DawidMachulak/MacroApp/print/instrukcja-montazu.html

Instrukcja montażu · wersja 1.0

# Makropad BLE 10 klawiszy + enkoder

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

Czas

4–6 h

Trudność

Średnia

Kroki

20

Lutów

ok. 60

## Zanim weźmiesz lutownicę

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

### Słowniczek — pięć pojęć, które wystarczą

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

### Lista części

# | Element | Ile | Uwagi

1 | Seeed XIAO nRF52840 (BLE) | 1 | Mózg całości, ma wbudowaną ładowarkę Li-Po
2 | Moduł PCF8574 | 1 | Bez zworek i goldpinów — tak jak masz
3 | Wyświetlacz OLED 0,91" SSD1306 I²C | 1 | 128 × 32 piksele, adres 0x3C
4 | Enkoder KY-040 | 1 | Bez goldpinów
5 | Przełączniki mechaniczne MX | 10 | Do wycięć 14 × 14 mm
6 | Keycapy | 10 | Raster w obudowie to 20 mm
7 | Przełącznik suwakowy SS12C40 | 1 | Trzy nóżki, używasz dwóch
8 | Akumulator Li-Po LP803450 1500 mAh | 1 | Z zabezpieczeniem PCM i wtykiem JST 2,54
9 | Wydruk: Dol.stl i Lid_final.stl | 1 kpl. | Sprawdź, czy wycięcia 14 × 14 mm nie są zarośnięte

### Materiały do dokupienia

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

### Narzędzia

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

## Jak to ma być połączone

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

## Etap 1 — Przygotowanie

Krok 1Przygotuj stanowisko

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

Krok 2Sprawdź komplet i przymierz na sucho

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

Krok 3Wtop gwinty M3 w dno

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

Krok 4Wciśnij 10 przełączników MX w pokrywę

Przełączniki wciskasz od góry pokrywy, tak żeby nóżki wystawały do środka obudowy.

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

Sprawdź: obróć pokrywę i potrząśnij lekko. Nic nie wypada, wszystkie nóżki sterczą w tę samą stronę.

Krok 5Potnij i ocynuj przewody

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

## Etap 2 — Lutowanie modułów na stole

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

Krok 6Ustaw adres PCF8574 i przylutuj do niego przewody

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

- Odetnij trzy krótkie kawałki czarnego przewodu (po 15 mm), ocynuj i połącz nimi A0, A1 oraz A2 z polem GND na tym samym module. Adres modułu to teraz 0x20.
- Przylutuj pięć przewodów o długości 70 mm: VCC (czerwony), GND (czarny), SDA (niebieski), SCL (żółty), INT (zielony).
- Przylutuj osiem białych przewodów po 150 mm do pól P0 … P7. Podpisz je taśmą: 1, 2, 3 … 8.

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

Uwaga na wersję układu. Jeśli na kostce jest napis PCF8574A, adresy są inne (0x38–0x3F) i jeden z nich koliduje z wyświetlaczem. Zweryfikujesz to skanerem w kroku 14 — na razie po prostu zerknij na napis i zapamiętaj.

Krok 7Przylutuj przewody do wyświetlacza OLED

- Wyświetlacz ma cztery pola, zwykle w kolejności GND · VCC · SCL · SDA. Przeczytaj napisy na swoim egzemplarzu — bywają inne kolejności i to jest najczęstsza przyczyna „nie działa".
- Przylutuj cztery przewody po 170 mm zgodnie z kolorami: GND czarny, VCC czerwony, SCL żółty, SDA niebieski.
- Lutuj szybko, po 2–3 sekundy na pole. Szkło wyświetlacza nie lubi długiego grzania.
- Kapnij kroplę kleju na gorąco na same przewody tuż obok lutów. To zabezpieczy je przed wyrwaniem pól przy szarpnięciu.

Sprawdź: pociągnij delikatnie za każdy przewód. Żaden się nie rusza, żadne pole nie odchodzi od płytki.

Krok 8Przylutuj przewody do enkodera KY-040

- Pięć pól: CLK · DT · SW · + · GND. Przylutuj pięć przewodów po 170 mm.
- Kolory: + czerwony, GND czarny, a CLK, DT, SW fioletowe. Podpisz te trzy fioletowe taśmą, bo są nie do rozróżnienia.
- Opcjonalnie, ale polecam: przylutuj dwa kondensatory 100 nF — jeden między CLK a GND, drugi między DT a GND, bezpośrednio na polach modułu. Kondensator nie ma biegunowości, więc nie da się go wlutować odwrotnie. Bez nich enkoder będzie czasem przeskakiwał o dwa kliknięcia.

Krok 9Przygotuj wyłącznik i przewody akumulatora

Wyłącznik SS12C40 ma trzy nóżki. Środkowa to wspólna, a z dwóch skrajnych używasz tylko jednej — dowolnej.

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

Krok 10Przylutuj wszystko do płytki XIAO

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

Jak podłączyć trzy rzeczy do jednego pola 3V3? Nie upychaj trzech przewodów w jeden otwór. Zamiast tego zrób skrętkę lutowaną: weź czerwone przewody od OLED-a, od enkodera i jeden dodatkowy kawałek 60 mm, skręć ich gołe końce razem, zalej cyną, nasuń koszulkę termokurczliwą i zgrzej. Ten jeden dodatkowy przewód lutujesz do 3V3 na XIAO. Dokładnie to samo zrób dla masy — z tym, że do skrętki masy dochodzi jeszcze czarny przewód od łańcucha klawiszy.

SDA i SCL do dwóch układów zrób inaczej, prościej: przewód z D4 idzie do pola SDA na wyświetlaczu, a z tego samego pola wyświetlacza wychodzi drugi przewód do SDA na PCF8574. Dwa przewody w jednym polu OLED-a to jeszcze da się zlutować. Tak samo z SCL.

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

Krok 11Zlutuj wspólną masę wszystkich klawiszy

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

Krok 12Przylutuj przewody sygnałowe klawiszy

- Do prawej nóżki klawiszy 1–8 przylutuj białe przewody idące od pól P0–P7 modułu PCF8574. Klawisz 1 do P0, klawisz 2 do P1 i tak dalej — trzymaj się numeracji z Rysunku 2.
- Do prawej nóżki klawisza 9 przylutuj fioletowy przewód z pola D6, a klawisza 10 — z pola D7.
- Prowadź przewody możliwie płasko po wewnętrznej stronie pokrywy, w stronę środka. Nie napinaj ich.

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

## Etap 3 — Test, zanim cokolwiek zamkniesz

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

Krok 13Sprawdź multimetrem, zanim podłączysz cokolwiek do prądu

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

- Test najważniejszy: jedna sonda na pole 3V3 XIAO, druga na GND. Nie może piszczeć. Jeśli piszczy — masz zwarcie zasilania i nie wolno Ci podłączyć USB, dopóki go nie znajdziesz.
- Powtórz to samo na polach VCC/GND wyświetlacza, enkodera i PCF8574. Wszędzie cisza.
- Sprawdź ciągłość zasilania: sonda na 3V3 XIAO i na VCC wyświetlacza — ma piszczeć. To samo dla enkodera i PCF8574. To potwierdza, że skrętka lutowana z kroku 10 faktycznie łączy.
- Sprawdź masę tak samo: GND XIAO ma piszczeć z masą każdego modułu i z nóżką dowolnego klawisza.
- Sprawdź, czy SDA i SCL nie są ze sobą zwarte — cisza.

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

Krok 14Pierwsze podłączenie USB i skanowanie magistrali

- Podłącz XIAO kablem USB-C do komputera. Na płytce powinna zapalić się dioda.
- Zainstaluj Arduino IDE. W Plik → Ustawienia dodaj adres płytek Seeed nRF52: https://files.seeedstudio.com/arduino/package_seeeduino_boards_index.json Następnie w menedżerze płytek zainstaluj pakiet Seeed nRF52 i wybierz płytkę Seeed XIAO nRF52840.
- Wgraj poniższy program (skaner magistrali) i otwórz Monitor portu szeregowego, prędkość 115200.

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

Krok 15Wgraj program testowy i sprawdź każdy klawisz

- W menedżerze bibliotek Arduino zainstaluj: PCF8574 (autor Rob Tillaart), Adafruit SSD1306 oraz Adafruit GFX Library.
- Wgraj program z następnej strony.
- Naciskaj klawisze po kolei, od 1 do 10, i patrz na wyświetlacz oraz na monitor portu. Każdy numer musi się pojawić i zniknąć po puszczeniu.
- Pokręć enkoderem w obie strony — licznik ma rosnąć i maleć. Wciśnij trzpień enkodera — ma pojawić się ENC.
- Zapisz sobie, co nie działa, i napraw wszystko teraz. Po zamknięciu obudowy dostęp do lutów wymaga rozkręcenia.

Sprawdź: dziesięć klawiszy, obrót w dwie strony, przycisk enkodera, tekst na wyświetlaczu. Komplet.

Krok 16Dopiero teraz podłącz akumulator

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

## Etap 4 — Montaż i zamknięcie

Krok 17Wklej elektronikę w dno

Kolejność ma znaczenie — od największego do najmniejszego, zaczynając od tego, co leży najgłębiej.

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

Krok 18Uformuj wiązkę i zrób pętlę serwisową

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

Rysunek 4. Zapas wiązki złożony w Z pozwala odłożyć pokrywę obok dna bez naprężania żadnego lutu.

Krok 19Test przed skręceniem — ostatnia szansa

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

Krok 20Skręć obudowę i nałóż keycapy

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

Gotowe. Zostało Ci już tylko oprogramowanie.

## Tabela połączeń — do powieszenia nad blatem

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

Piny wolne: D8, D9, D10 — możesz podpiąć pod nie brzęczyk, diodę statusu albo dodatkowy przełącznik.

## Program testowy

#include <Wire.h>
#include <PCF8574.h>
#include <Adafruit_GFX.h>
#include <Adafruit_SSD1306.h>

PCF8574 pcf(0x20);
Adafruit_SSD1306 oled(128, 32, &Wire, -1);

int  poprzedniA = HIGH;
long licznik = 0;

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

Jeśli enkoder liczy w odwrotną stronę, niż kręcisz — zamień w programie D0 z D1. Nie musisz nic przelutowywać.

## Kiedy coś nie działa

Objaw | Co sprawdzić, w tej kolejności
Komputer w ogóle nie widzi XIAO | Zmień kabel na taki z transmisją danych. Potem wciśnij dwa razy szybko reset — płytka pojawi się jako pendrive.
Skaner I²C nie znajduje niczego | Zamienione SDA ze SCL to przyczyna numer jeden. Potem: brak zasilania modułów (zmierz 3,3 V między VCC a GND wyświetlacza), na końcu zimne luty.
Skaner widzi tylko 0x3C | PCF8574 nie ma zasilania albo ma inny adres. Sprawdź ciągłość VCC i GND do modułu, potem czy A0, A1, A2 faktycznie dotykają masy.
Skaner pokazuje 0x27 zamiast 0x20 | Przewody adresowe nie łączą. Przelutuj je.
Skaner pokazuje adres z zakresu 0x38–0x3F | Masz układ PCF8574A. Wpisz znaleziony adres do programu w miejsce 0x20. Gdyby wypadł dokładnie 0x3C — koliduje z wyświetlaczem; przełóż wtedy jeden z przewodów adresowych z GND na VCC.
Wyświetlacz świeci, ale nic nie pokazuje | Sprawdź rozmiar w programie: moduł 0,91 cala to 128, 32, nie 128, 64.
Jeden klawisz jest „wciśnięty" cały czas | Zwarcie między jego nóżkami albo kropla cyny mostkująca sąsiednie pola na PCF8574.
Jeden klawisz nie reaguje wcale | Przerwa. Przyłóż brzęczyk między jego pole na PCF8574 a nóżkę przełącznika, przy wciśniętym klawiszu.
Enkoder przeskakuje o dwa | Dolutuj kondensatory 100 nF z kroku 8. To najczęstsza dolegliwość KY-040.
Nie ładuje się | Wyłącznik jest w pozycji OFF. Przerywa on plus akumulatora, więc do ładowania urządzenie musi być włączone.
Działa na USB, nie działa na akumulatorze | Zimny lut na polu BAT+ lub BAT− albo źle podłączony wyłącznik. Zmierz napięcie na polu BAT+ przy włączonym wyłączniku — ma być ok. 3,7–4,2 V.

## Trzy rzeczy, o których warto wiedzieć

### W obudowie nie ma otworu na USB-C

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

### Ładowanie potrwa bardzo długo

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

### Co dalej z oprogramowaniem

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

Wymiary i położenia elementów w tej instrukcji zostały odczytane bezpośrednio z plików Dol.stl i Lid_final.stl. Obudowa ma 109,8 × 87,75 mm, prześwit wewnętrzny 12 mm, raster klawiszy 20 mm, wycięcia 14 × 14 mm.
